banyi97/Frequency_Counter/Nyak/hazi_kiindulas/hallglib.xlsx

Item # | Column=Supplier | Column=Reference | Column=Name | Column=Quantity
1
2
3
