banyi97/Frequency_Counter/(list of files, drawings)

Other design files:
Nyak/hallglib.SchLib
Nyak/hazi_kiindulas/hazi_kiindulas.PcbDoc
Nyak/hazi_kiindulas/MLAB_Hazi.PrjPcb
Nyak/hazi_kiindulas/Nucleo.SchDoc
