banyi97/Frequency_Counter/FreqCounterTav/FreqV2/Core/Src/main.c

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

/* Includes ------------------------------------------------------------------*/
#include "main.h"

/* USER CODE BEGIN Includes */
#include "arm_math.h"
#include "arm_common_tables.h"

/* USER CODE END Includes */

/* USER CODE BEGIN PD */
#define Ts 1/20000
/* USER CODE END PD */

DAC_HandleTypeDef hdac;

UART_HandleTypeDef huart2;

/* USER CODE BEGIN PV */
uint8_t START_FRAME = 0xAA;
float32_t PI_2 = 2 * PI;
uint32_t freq = 2000;
uint32_t calcFreq = 0;
uint32_t fallCntr = 0;
float32_t phase = 0;

uint8_t rxBuffer[4];
uint8_t *p = rxBuffer;
uint8_t count = 0;

uint16_t sendFreq;
 uint8_t txBuff[3];
 uint8_t* tx = txBuff;

TIM_HandleTypeDef tim;
TIM_HandleTypeDef dac_tim;
/* USER CODE END PV */

void SystemClock_Config(void);
static void MX_GPIO_Init(void);
static void MX_USART2_UART_Init(void);
static void MX_DAC_Init(void);
/* USER CODE BEGIN PFP */
static void TimerInit(void);
static void DAC_Tim(void);
uint8_t gencrc(uint8_t *data, size_t len);
/* USER CODE END PFP */

/* USER CODE BEGIN 0 */
void HAL_UART_RxCpltCallback(UART_HandleTypeDef *huart){
	if(huart->Instance == USART2){
		if(rxBuffer[count++] == START_FRAME){
			rxBuffer[0] = START_FRAME;
			count = 1;
		}
		if(count > 3){
			count = 0;
			if(rxBuffer[3] == gencrc(p, 3)){
				uint16_t f = 0;
				f |= rxBuffer[1];
				f |= rxBuffer[2] << 8;
				if(f > 9999){
					f = 9999;
				}
				freq = f;
				tim.Instance->CNT = 0;
				fallCntr = 0;
			}
		}
		HAL_UART_Receive_IT(&huart2, (p+count), 1);
	}
}
/* USER CODE END 0 */

/**
  * @brief  The application entry point.
  * @retval int
  */
int main(void)
{
  /* MCU Configuration--------------------------------------------------------*/

  /* Reset of all peripherals, Initializes the Flash interface and the Systick. */
  HAL_Init();

  /* Configure the system clock */
  SystemClock_Config();

  /* Initialize all configured peripherals */
  MX_GPIO_Init();
  MX_USART2_UART_Init();
  MX_DAC_Init();
  /* USER CODE BEGIN 2 */
  DAC_Tim();
  TimerInit();
  HAL_DAC_Start(&hdac, DAC_CHANNEL_1);
  /* USER CODE END 2 */

  /* Infinite loop */
  /* USER CODE BEGIN WHILE */

  while (1)
  {
	sendFreq = calcFreq; // local copy
	if(sendFreq > 9999){
		sendFreq = 9999;
	}
	// SEG 1
	uint8_t thouse = sendFreq / 1000;
	txBuff[0] = START_FRAME;
	txBuff[1] = thouse | 0x80;
	txBuff[2] = gencrc(tx, 2);
	HAL_UART_Transmit(&huart2, tx, 3, 1000);
	// SEG 2
	sendFreq -= thouse * 1000;
	uint8_t hundr = sendFreq / 100;
	txBuff[1] = hundr | 0x40;
	txBuff[2] = gencrc(tx, 2);
	HAL_UART_Transmit(&huart2, tx, 3, 1000);
	sendFreq -= hundr * 100;
	// SEG 3
	uint8_t ten = sendFreq / 10;
	txBuff[1] = ten | 0x20;
	txBuff[2] = gencrc(tx, 2);
	HAL_UART_Transmit(&huart2, tx, 3, 1000);
	sendFreq -= ten * 10;
	// SEG 4
	txBuff[1] = sendFreq | 0x10;
	txBuff[2] = gencrc(tx, 2);
	HAL_UART_Transmit(&huart2, tx, 3, 1000);
    /* USER CODE END WHILE */

    /* USER CODE BEGIN 3 */
  }
  /* USER CODE END 3 */
}

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
/* USER CODE BEGIN 4 */
static void DAC_Tim(){
	__TIM2_CLK_ENABLE(); //84Mhz - 10kHz 7,0x419 - 20kHz 0,0x1067
	dac_tim.Instance = TIM2;
	dac_tim.Init.ClockDivision = TIM_CLOCKDIVISION_DIV1;
	dac_tim.Init.CounterMode = TIM_COUNTERMODE_UP;
	dac_tim.Init.Prescaler = 0; // 0 + 1
	dac_tim.Init.Period = 0x1067; // 4199 + 1
	dac_tim.State = HAL_TIM_STATE_RESET;

	HAL_TIM_Base_Init(&dac_tim);

	HAL_NVIC_SetPriority(TIM2_IRQn, 0, 2);
	HAL_NVIC_EnableIRQ(TIM2_IRQn);

	HAL_TIM_Base_Start_IT(&dac_tim);
}
static void TimerInit(){
	__TIM4_CLK_ENABLE(); // 84Mhz - 1Hz 0xC7F,0x6689
	tim.Instance = TIM4;
	tim.Init.ClockDivision = TIM_CLOCKDIVISION_DIV1;
	tim.Init.CounterMode = TIM_COUNTERMODE_UP;
	tim.Init.Prescaler = 0xC7F; // 3199 + 1
	tim.Init.Period = 0x6689; // 26249 + 1
	tim.State = HAL_TIM_STATE_RESET;

	HAL_TIM_Base_Init(&tim);

	HAL_NVIC_SetPriority(TIM4_IRQn, 0, 3);
	HAL_NVIC_EnableIRQ(TIM4_IRQn);

	HAL_TIM_Base_Start_IT(&tim);
}

void HAL_TIM_PeriodElapsedCallback(TIM_HandleTypeDef * htim)
{
	if (htim->Instance == TIM4)
	{
		calcFreq = fallCntr;
		fallCntr = 0;
	}
	if (htim->Instance == TIM2)
	{
		phase += (float32_t)(PI_2 * (float32_t)freq * Ts);
		if(phase > PI_2){
			phase -= PI_2;
		}
		if(phase < PI){
			HAL_DAC_SetValue(&hdac, DAC_CHANNEL_1, DAC_ALIGN_12B_R, 0x00000000);
		}
		else{
			HAL_DAC_SetValue(&hdac, DAC_CHANNEL_1, DAC_ALIGN_12B_R, 0xFFFFFFFF);
		}
		//float32_t out_temp = 1 + 1 * arm_sin_f32(phase) + 1/3 * arm_sin_f32(phase * 3) + 1/5 * arm_sin_f32(phase * 5) + 1/7 * arm_sin_f32(phase * 7) + 1/9 * arm_sin_f32(phase * 9);
		//uint32_t out = (uint32_t)(out_temp * 4096);
		//HAL_DAC_SetValue(&hdac, DAC_CHANNEL_1, DAC_ALIGN_12B_R, out);
	}
}
void HAL_GPIO_EXTI_Callback(uint16_t gpio){
	if(gpio == GPIO_PIN_10){
		fallCntr++;
	}
}
uint8_t gencrc(uint8_t *data, size_t len)
{
    uint8_t crc = 0xff;
    size_t i, j;
    for (i = 0; i < len; i++) {
        crc ^= data[i];
        for (j = 0; j < 8; j++) {
            if ((crc & 0x80) != 0)
                crc = (uint8_t)((crc << 1) ^ 0x31);
            else
                crc <<= 1;
        }
    }
    if(crc == 0xAA)
    	crc ^= 0xFF;
    return crc;
}
/* USER CODE END 4 */
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
